lara00/3d-druck-schubladen-kalender/stl/1_Monatskalender/1_Module/modul_10_oktober.stl

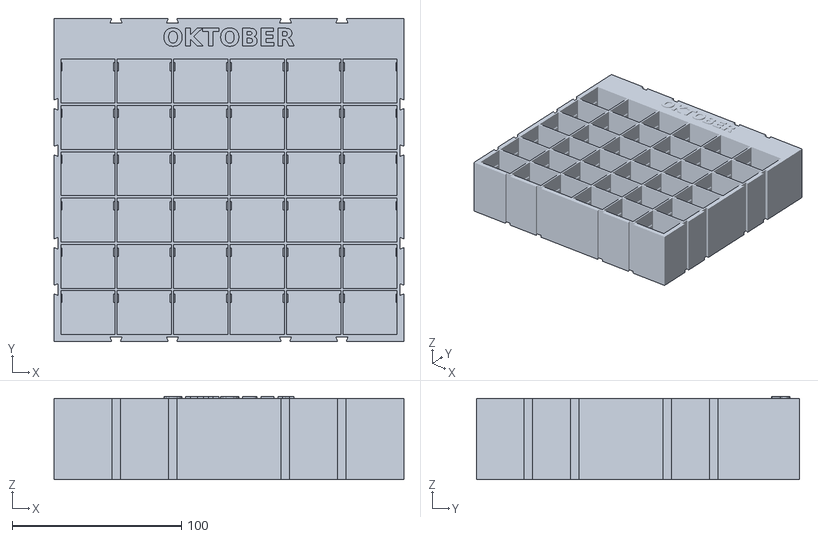
[picture p1: CAD file, 2026-10-16]
stl/1_Monatskalender/1_Module/modul_10_oktober.stl
207.0 x 191.0 x 49.2
