lara00/3d-druck-schubladen-kalender/stl/1_Monatskalender/2_Schubladen/schubladen_tag_01-31_12x_drucken.stl

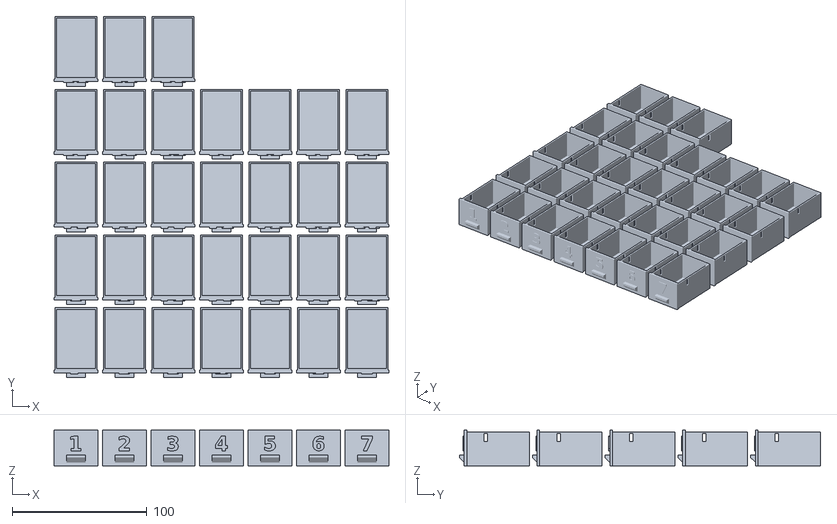
[picture p2: CAD file, 2026-10-16]
stl/1_Monatskalender/2_Schubladen/schubladen_tag_01-31_12x_drucken.stl
248.4 x 267.8 x 26.4
