lara00/3d-druck-schubladen-kalender/stl/1_Monatskalender/3_Verbinder/verbinder_68x.stl

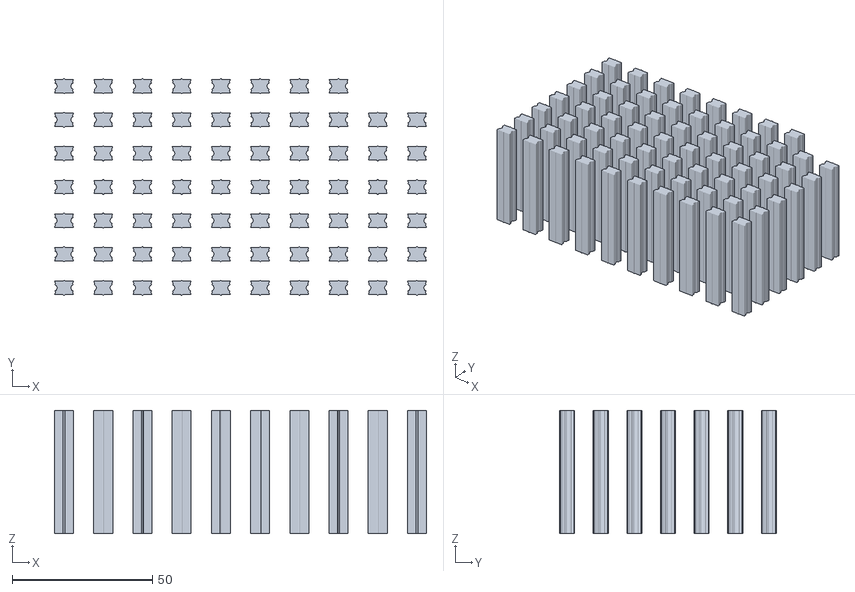
[picture p3: CAD file, 2026-10-16]
stl/1_Monatskalender/3_Verbinder/verbinder_68x.stl
132.8 x 77.4 x 44.0
