lara00/3d-druck-schubladen-kalender/stl/1_Monatskalender/4_Abschlussleisten/leiste_rechts_oben_ecke.stl

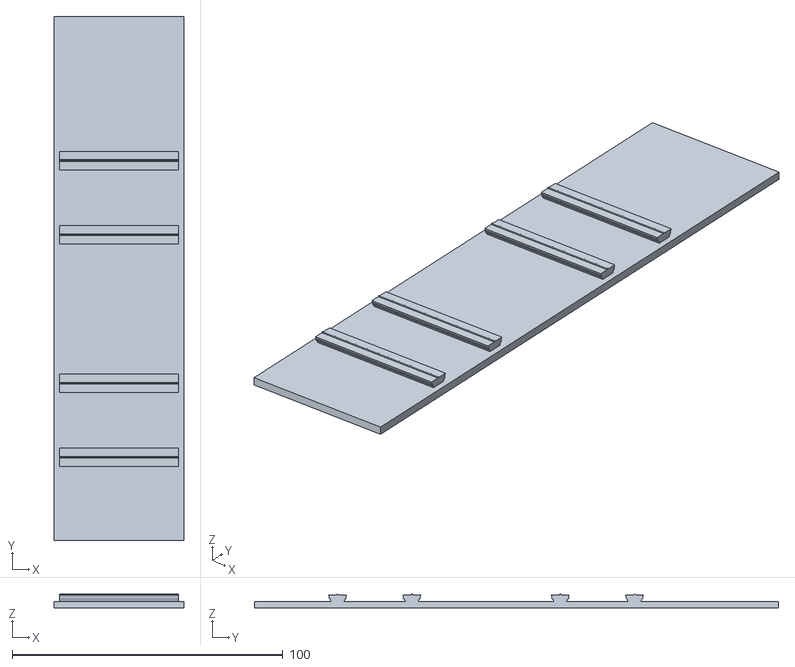
[picture p4: CAD file, 2026-10-16]
stl/1_Monatskalender/4_Abschlussleisten/leiste_rechts_oben_ecke.stl
48.0 x 193.5 x 5.20
