lara00/3d-druck-schubladen-kalender/stl/2_Adventskalender/advent_schubladen_1-24.stl

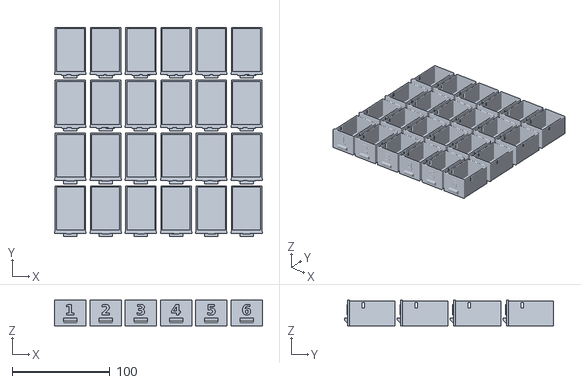
[picture p5: CAD file, 2026-10-16]
stl/2_Adventskalender/advent_schubladen_1-24.stl
212.4 x 213.8 x 26.4
