lara00/3d-druck-schubladen-kalender/stl/3_Testmodul/testmodul_2x2.stl

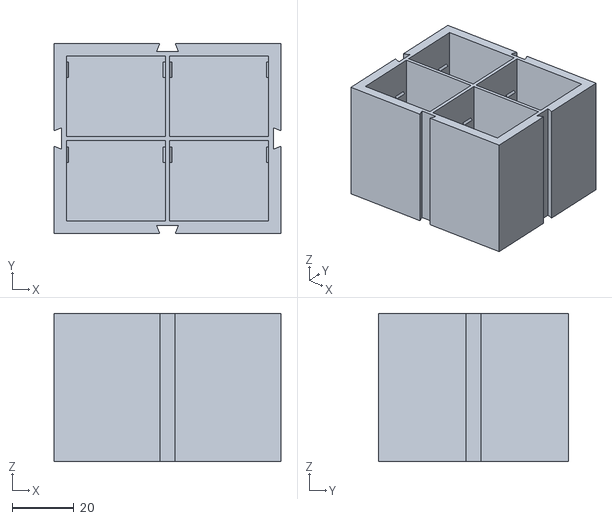
[picture p6: CAD file, 2026-10-16]
stl/3_Testmodul/testmodul_2x2.stl
73.4 x 61.4 x 48.0
