lara00/3d-druck-schubladen-kalender/stl/4_Extra_Schubladen/doppel_schubladen_4_2x.stl

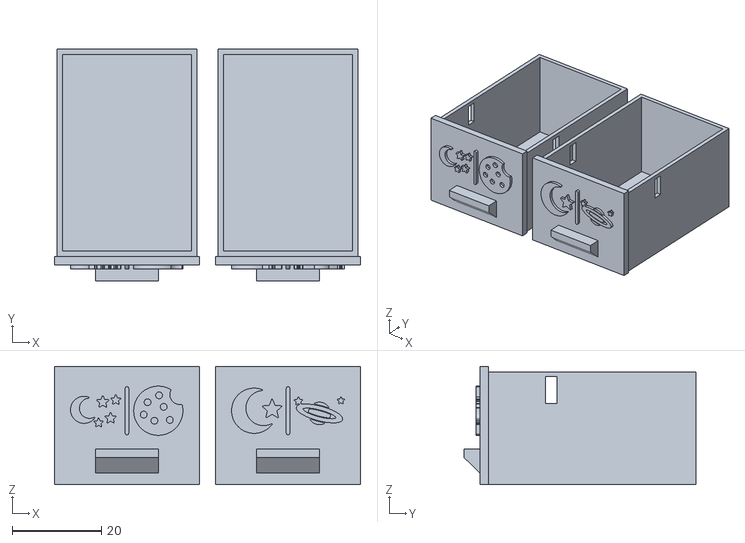
[picture p7: CAD file, 2026-10-16]
stl/4_Extra_Schubladen/doppel_schubladen_4_2x.stl
68.4 x 51.8 x 26.4
