lara00/3d-druck-schubladen-kalender/stl/4_Extra_Schubladen/monat_zahlen/zahlen_okt_01-31.stl

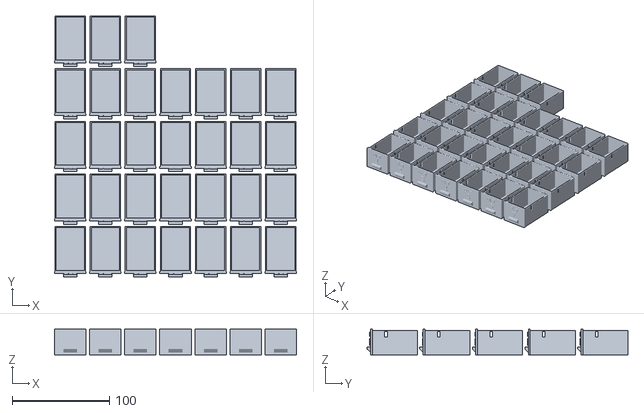
[picture p8: CAD file, 2026-10-16]
stl/4_Extra_Schubladen/monat_zahlen/zahlen_okt_01-31.stl
248.4 x 267.8 x 26.4
