lara00/3d-druck-schubladen-kalender/stl/4_Extra_Schubladen/tage_im_jahr/tage_04_109-144.stl

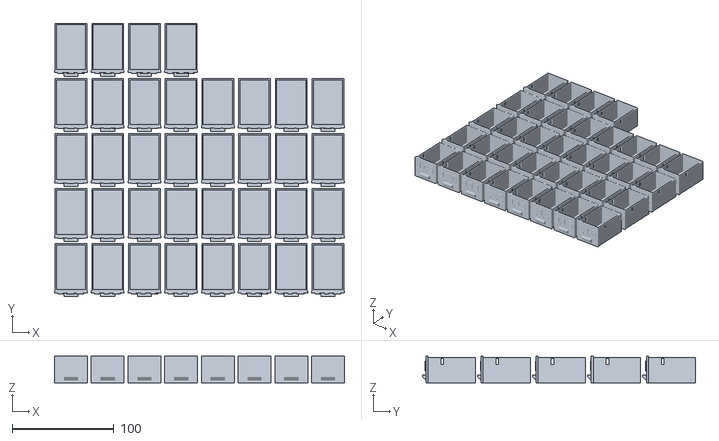
[picture p9: CAD file, 2026-10-16]
stl/4_Extra_Schubladen/tage_im_jahr/tage_04_109-144.stl
284.4 x 267.8 x 26.4
