lara00/3d-druck-schubladen-kalender/stl/4_Extra_Schubladen/weitere_symbole/schubladen_zeichen_10x.stl

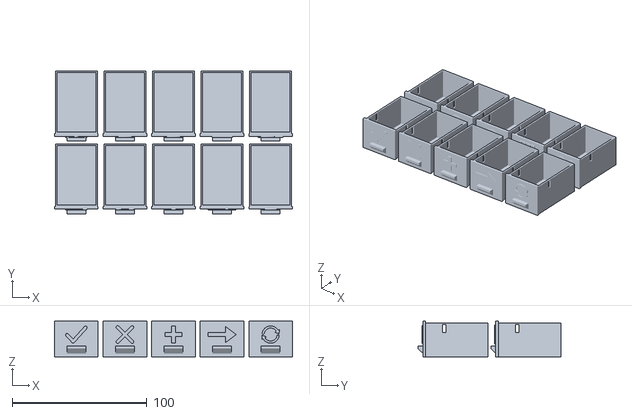
[picture p10: CAD file, 2026-10-16]
stl/4_Extra_Schubladen/weitere_symbole/schubladen_zeichen_10x.stl
176.4 x 105.8 x 26.4
