lara00/3d-druck-schubladen-kalender/stl/4_Extra_Schubladen/welt_feiertage/schubladen_religionen_11x.stl

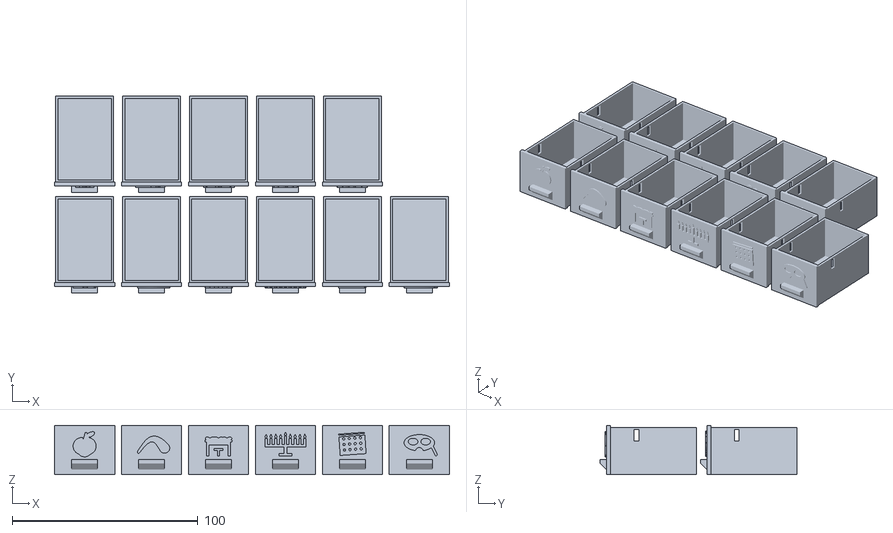
[picture p11: CAD file, 2026-10-16]
stl/4_Extra_Schubladen/welt_feiertage/schubladen_religionen_11x.stl
212.4 x 105.8 x 26.4
