lara00/3d-druck-schubladen-kalender/stl/einzeln/wz_su_03.stl

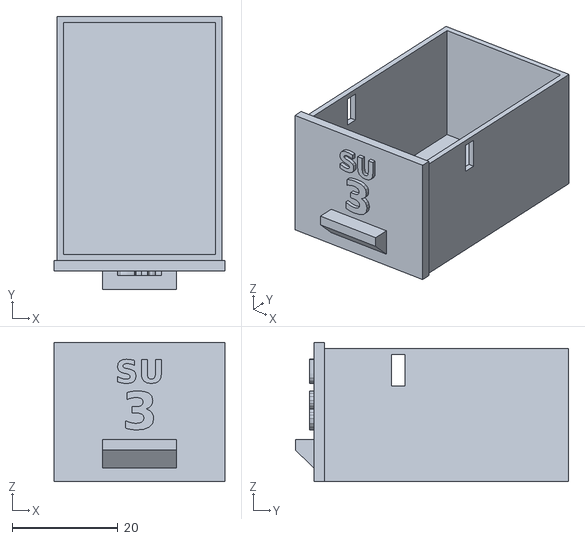
[picture p12: CAD file, 2026-10-16]
stl/einzeln/wz_su_03.stl
32.4 x 51.8 x 26.4
