lara00/3d-druck-schubladen-kalender/stl/1_Monatskalender/4_Abschlussleisten/leiste_oben_unten_8x.stl

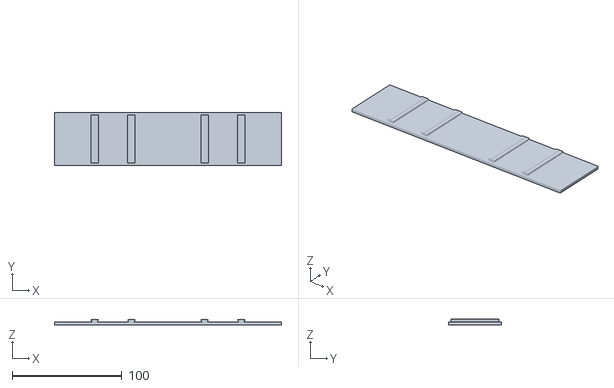
[picture p13: CAD file, 2026-10-16]
stl/1_Monatskalender/4_Abschlussleisten/leiste_oben_unten_8x.stl
207.0 x 48.0 x 5.20
