lara00/3d-druck-schubladen-kalender/stl/2_Adventskalender/advent_regal.stl

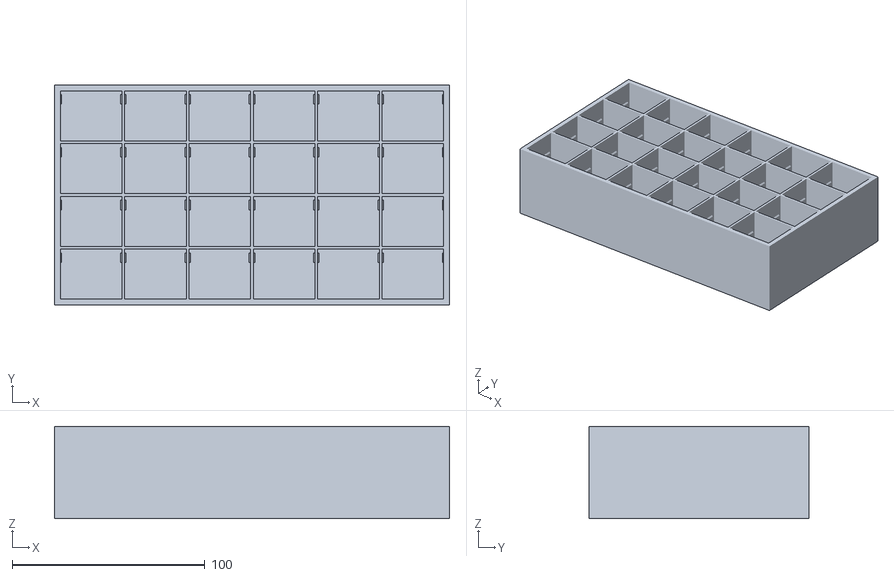
[picture p14: CAD file, 2026-10-16]
stl/2_Adventskalender/advent_regal.stl
205.0 x 114.2 x 48.0
