lara00/3d-druck-schubladen-kalender/stl/3_Testmodul/test_verbinder_passungen_6x.stl

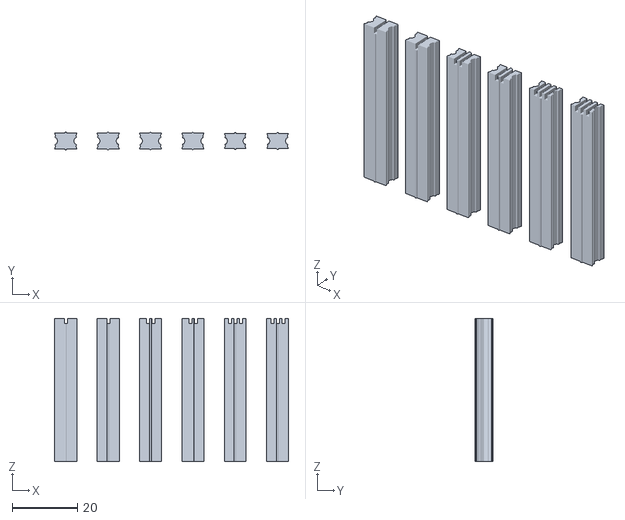
[picture p15: CAD file, 2026-10-16]
stl/3_Testmodul/test_verbinder_passungen_6x.stl
71.8 x 5.50 x 44.0
