lara00/3d-druck-schubladen-kalender/stl/4_Extra_Schubladen/schubladen_jahreszeiten_feste_6x.stl

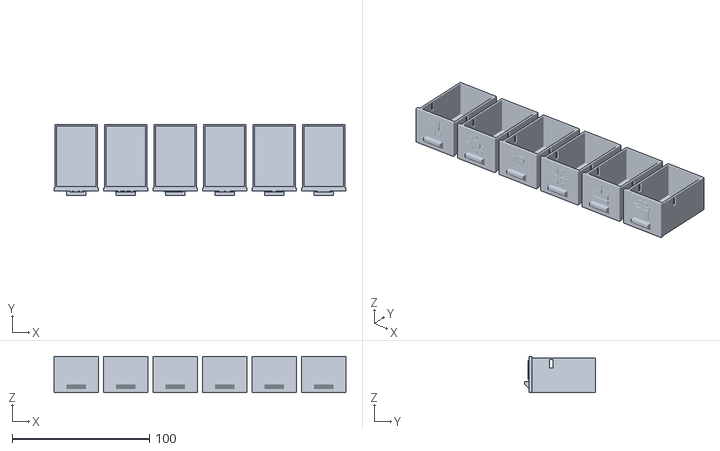
[picture p16: CAD file, 2026-10-16]
stl/4_Extra_Schubladen/schubladen_jahreszeiten_feste_6x.stl
212.4 x 51.8 x 26.4
