lara00/3d-druck-schubladen-kalender/stl/5_Stimmungskalender/mood_calendar_modul.stl

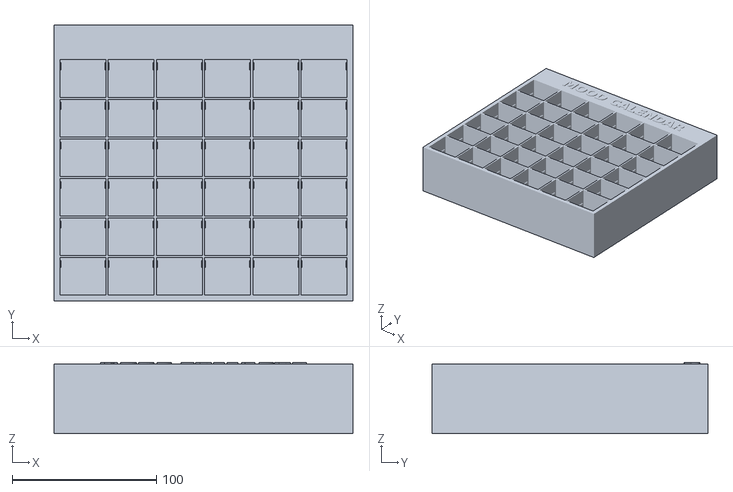
[picture p18: CAD file, 2026-10-16]
stl/5_Stimmungskalender/mood_calendar_modul.stl
207.0 x 191.0 x 49.2
