lara00/3d-druck-schubladen-kalender/stl/4_Extra_Schubladen/schubladen_symbole_7x.stl

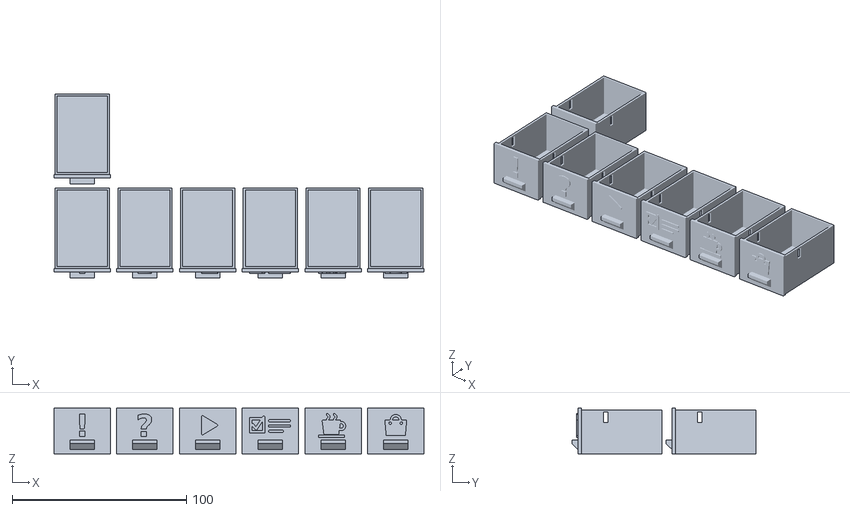
[picture p19: CAD file, 2026-10-16]
stl/4_Extra_Schubladen/schubladen_symbole_7x.stl
212.4 x 105.8 x 26.4
