lara00/3d-druck-schubladen-kalender/stl/4_Extra_Schubladen/welt_feiertage/schubladen_international_13x.stl

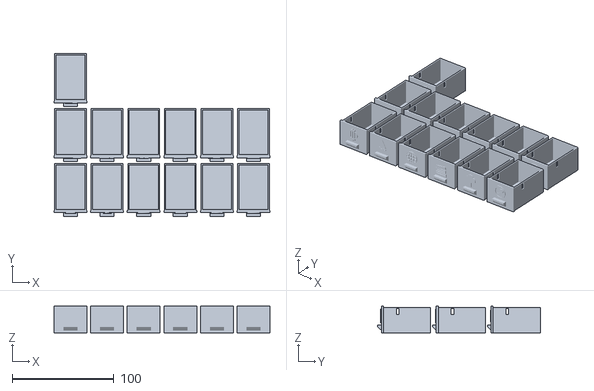
[picture p20: CAD file, 2026-10-16]
stl/4_Extra_Schubladen/welt_feiertage/schubladen_international_13x.stl
212.4 x 159.8 x 26.4
