lara00/3d-druck-schubladen-kalender/stl/3_Testmodul/test_abschlussleisten_4x.stl

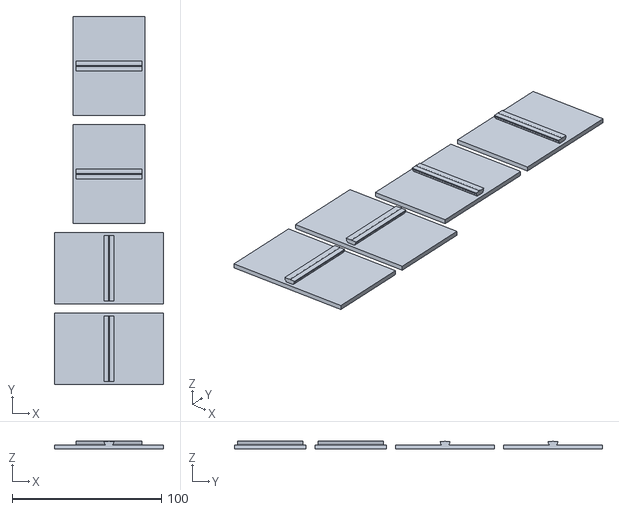
[picture p21: CAD file, 2026-10-16]
stl/3_Testmodul/test_abschlussleisten_4x.stl
73.4 x 246.8 x 5.20
