lara00/3d-druck-schubladen-kalender/stl/6_Lernkalender/schubladen_stunden_15min-7h30_30x.stl

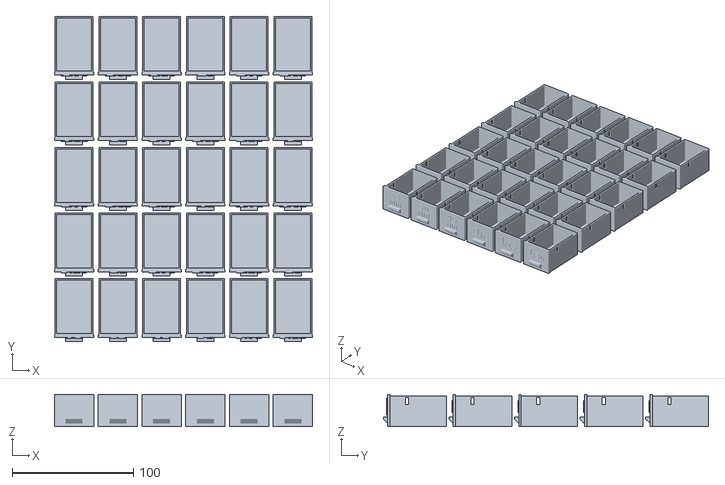
[picture p22: CAD file, 2026-10-16]
stl/6_Lernkalender/schubladen_stunden_15min-7h30_30x.stl
212.4 x 267.8 x 26.4
