lara00/3d-druck-schubladen-kalender/stl/4_Extra_Schubladen/monat_zahlen/zahlen_feb_01-29.stl

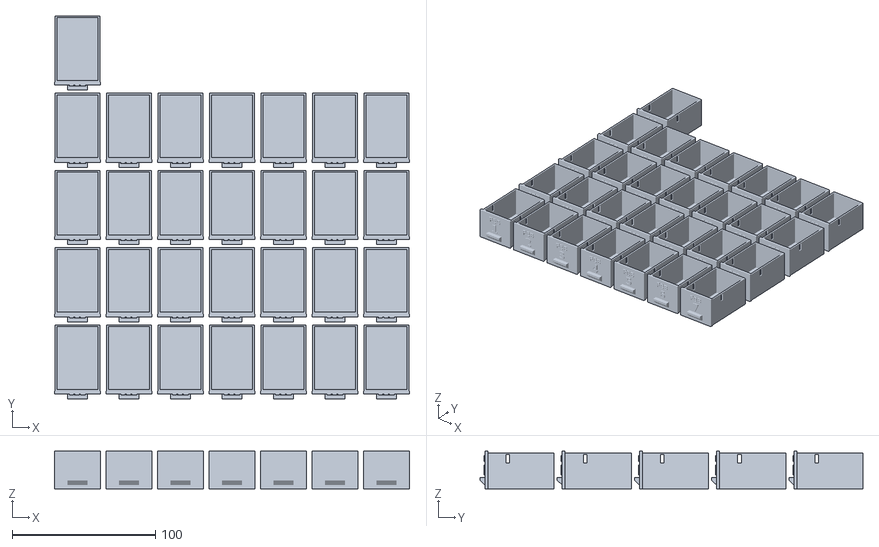
[picture p23: CAD file, 2026-10-16]
stl/4_Extra_Schubladen/monat_zahlen/zahlen_feb_01-29.stl
248.4 x 267.8 x 26.4
