lara00/3d-druck-schubladen-kalender/stl/4_Extra_Schubladen/schubladen_feiertage_20x.stl

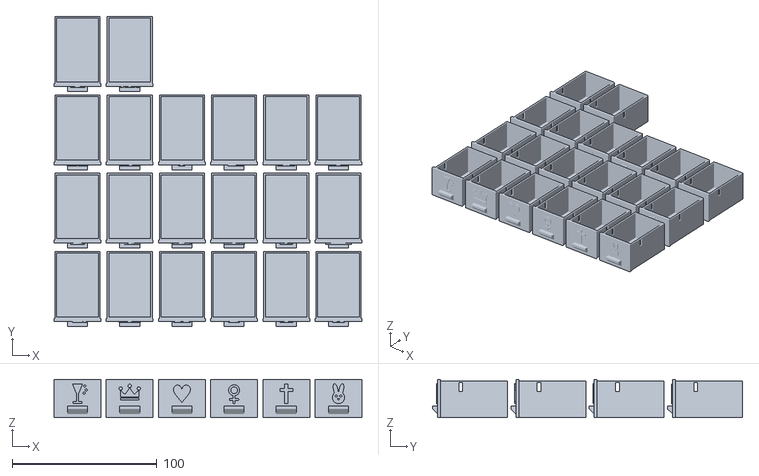
[picture p24: CAD file, 2026-10-16]
stl/4_Extra_Schubladen/schubladen_feiertage_20x.stl
212.4 x 213.8 x 26.4
