lara00/3d-druck-schubladen-kalender/stl/4_Extra_Schubladen/monat_zahlen/zahlen_nov_01-30.stl

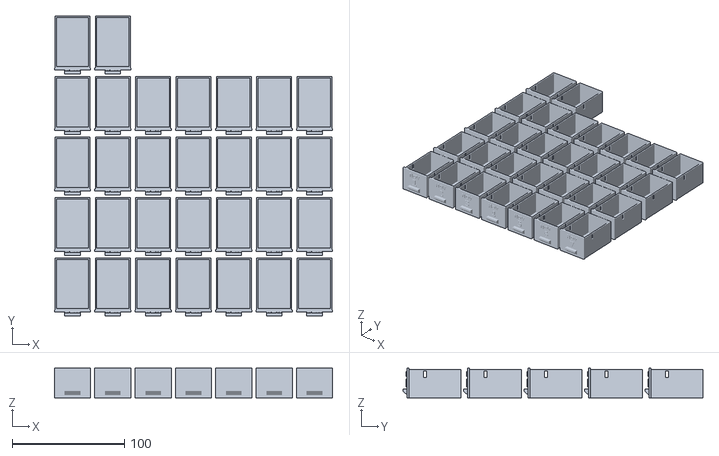
[picture p26: CAD file, 2026-10-16]
stl/4_Extra_Schubladen/monat_zahlen/zahlen_nov_01-30.stl
248.4 x 267.8 x 26.4
