lara00/3d-druck-schubladen-kalender/stl/4_Extra_Schubladen/weitere_symbole/schubladen_gesichter2_20x.stl

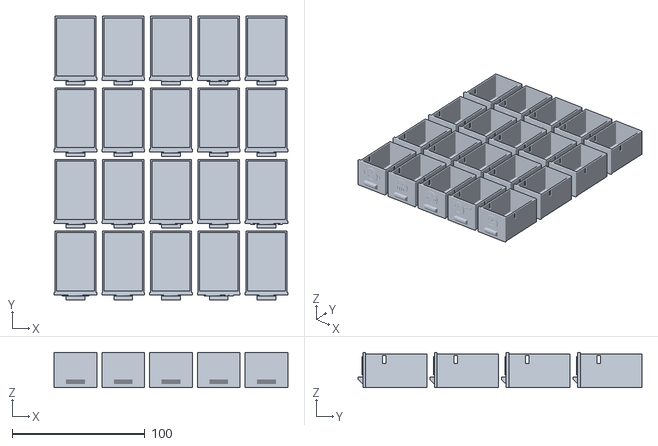
[picture p27: CAD file, 2026-10-16]
stl/4_Extra_Schubladen/weitere_symbole/schubladen_gesichter2_20x.stl
176.4 x 213.8 x 26.4
