lara00/3d-druck-schubladen-kalender/stl/einzeln/zeichen_0050.stl

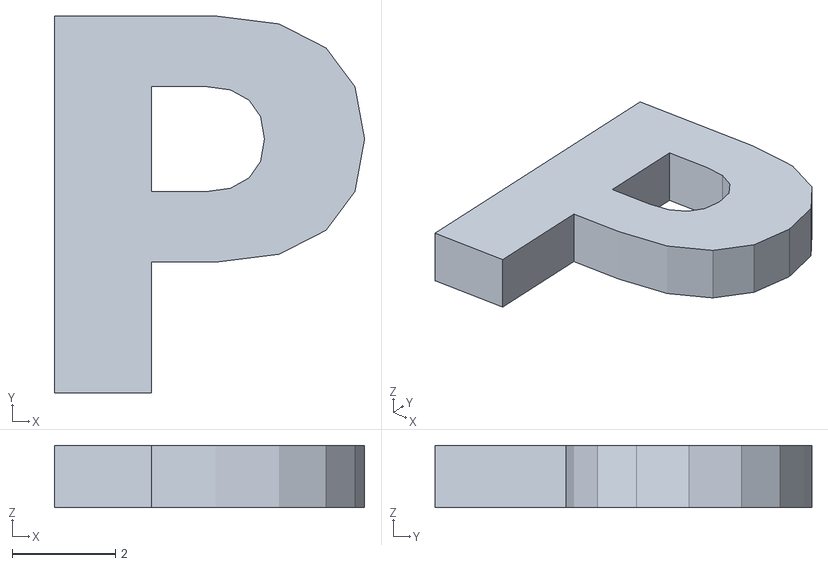
[picture p28: CAD file, 2026-10-16]
stl/einzeln/zeichen_0050.stl
6.00 x 7.29 x 1.20
