lara00/3d-druck-schubladen-kalender/stl/4_Extra_Schubladen/schubladen_laender_feiertage_21x.stl

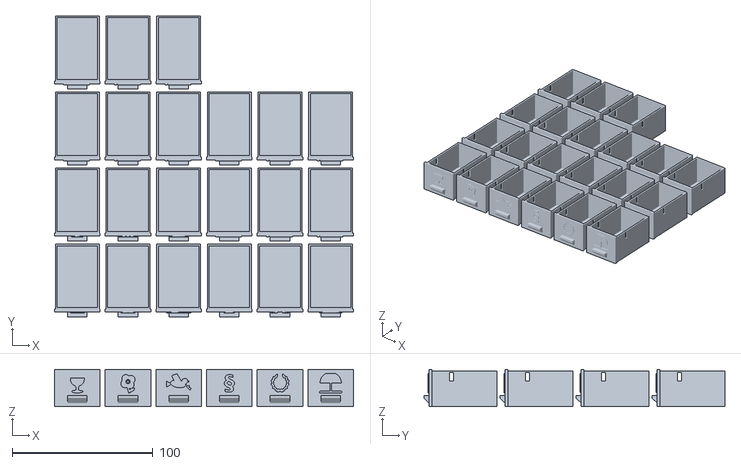
[picture p30: CAD file, 2026-10-16]
stl/4_Extra_Schubladen/schubladen_laender_feiertage_21x.stl
212.4 x 213.8 x 26.4
