lara00/3d-druck-schubladen-kalender/stl/4_Extra_Schubladen/buchstaben_gross_29x.stl

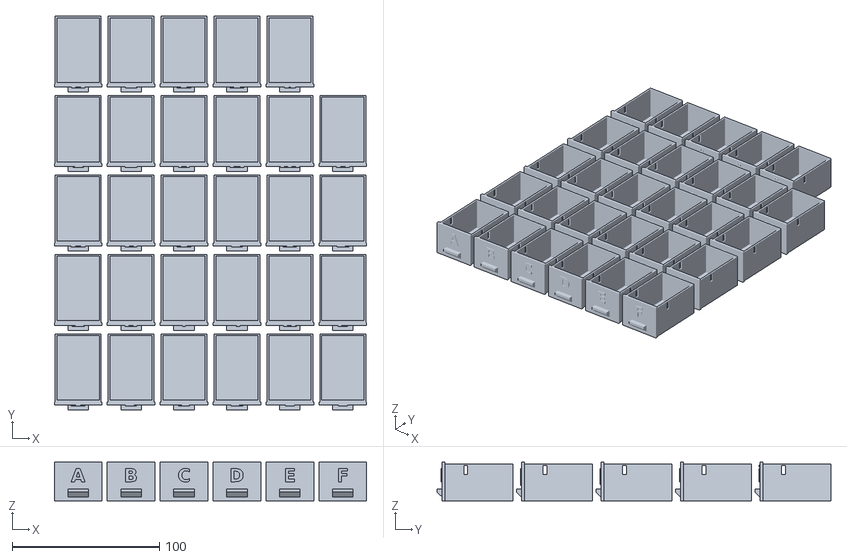
[picture p32: CAD file, 2026-10-16]
stl/4_Extra_Schubladen/buchstaben_gross_29x.stl
212.4 x 267.8 x 26.4
