lara00/3d-druck-schubladen-kalender/(list of files, cad)

Other CAD files:
stl/1_Monatskalender/1_Module_EN/module_07_july.stl
stl/4_Extra_Schubladen/wochentag_zahlen/zahlen_so_01-31.stl
stl/5_Stimmungskalender/mood_calendar_modul_mit_nuten.stl
stl/6_Lernkalender/lernkalender_modul_mit_nuten.stl
stl/1_Monatskalender/1_Module/modul_07_juli.stl
stl/1_Monatskalender/1_Module_EN/module_05_may.stl
stl/4_Extra_Schubladen/monat_zahlen/zahlen_mai_01-31.stl
stl/4_Extra_Schubladen/tage_im_jahr/tage_03_073-108.stl
stl/4_Extra_Schubladen/welt_feiertage/schubladen_laender_12x.stl
stl/4_Extra_Schubladen/wochentag_zahlen/zahlen_th_01-31.stl
stl/einzeln/n_paragraph.stl
stl/1_Monatskalender/1_Module/modul_01_januar.stl
stl/1_Monatskalender/1_Module_EN/module_10_october.stl
stl/1_Monatskalender/4_Abschlussleisten/leiste_rechts_unten_ecke.stl
stl/3_Testmodul/test_schubladen_1-12.stl
stl/4_Extra_Schubladen/monat_zahlen/zahlen_maer_01-31.stl
stl/4_Extra_Schubladen/tage_im_jahr/tage_11_361-366.stl
stl/4_Extra_Schubladen/weitere_symbole/schubladen_essen_10x.stl
stl/4_Extra_Schubladen/wochentag_zahlen/zahlen_do_01-31.stl
stl/5_Stimmungskalender/stimmung_3_okay_10x.stl
stl/6_Lernkalender/study_calendar_modul.stl
stl/einzeln/wz_di_23.stl
stl/1_Monatskalender/1_Module/modul_05_mai.stl
stl/1_Monatskalender/1_Module_EN/module_09_september.stl
stl/1_Monatskalender/4_Abschlussleisten/leiste_links_unten_ecke.stl
stl/4_Extra_Schubladen/monat_zahlen/zahlen_aug_01-31.stl
stl/4_Extra_Schubladen/schubladen_alltag_12x.stl
stl/4_Extra_Schubladen/tage_im_jahr/tage_09_289-324.stl
stl/4_Extra_Schubladen/weitere_symbole/schubladen_natur_10x.stl
stl/4_Extra_Schubladen/welt_feiertage/schubladen_aktionstage_12x.stl
stl/4_Extra_Schubladen/wochentag_zahlen/zahlen_mi_01-31.stl
stl/einzeln/wz_th_19.stl
stl/1_Monatskalender/1_Module/modul_03_maerz.stl
stl/1_Monatskalender/1_Module_EN/module_11_november.stl
stl/1_Monatskalender/4_Abschlussleisten/leiste_links_oben_ecke.stl
stl/4_Extra_Schubladen/tage_im_jahr/tage_02_037-072.stl
stl/4_Extra_Schubladen/weitere_symbole/schubladen_feiern_10x.stl
stl/4_Extra_Schubladen/wochentag_zahlen/zahlen_we_01-31.stl
stl/5_Stimmungskalender/stimmungskalender_modul.stl
stl/6_Lernkalender/lernkalender_modul.stl
stl/einzeln/tag_074.stl
stl/1_Monatskalender/1_Module/modul_04_april.stl
stl/1_Monatskalender/1_Module_EN/module_03_march.stl
stl/1_Monatskalender/4_Abschlussleisten/leiste_rechts_mitte.stl
stl/4_Extra_Schubladen/monat_zahlen/zahlen_dec_01-31.stl
stl/4_Extra_Schubladen/tage_im_jahr/tage_10_325-360.stl
stl/4_Extra_Schubladen/weitere_symbole/schubladen_tiere_10x.stl
stl/4_Extra_Schubladen/wochentag_zahlen/zahlen_su_01-31.stl
stl/5_Stimmungskalender/stimmungskalender_modul_mit_nuten.stl
stl/6_Lernkalender/study_calendar_modul_mit_nuten.stl
stl/einzeln/tag_221.stl
stl/1_Monatskalender/1_Module/modul_12_dezember.stl
stl/1_Monatskalender/1_Module_EN/module_06_june.stl
stl/1_Monatskalender/4_Abschlussleisten/leiste_links_mitte.stl
stl/4_Extra_Schubladen/monat_zahlen/zahlen_dez_01-31.stl
stl/4_Extra_Schubladen/schubladen_termine_12x.stl
stl/4_Extra_Schubladen/tage_im_jahr/tage_08_253-288.stl
stl/4_Extra_Schubladen/weitere_symbole/schubladen_buero_10x.stl
stl/4_Extra_Schubladen/wochentag_zahlen/zahlen_tu_01-31.stl
stl/5_Stimmungskalender/stimmung_4_gut_10x.stl
stl/6_Lernkalender/schubladen_stunden_7h45-15h_30x.stl
stl/einzeln/n_europa.stl
stl/1_Monatskalender/1_Module/modul_02_februar.stl
stl/1_Monatskalender/1_Module_EN/module_04_april.stl
stl/4_Extra_Schubladen/monat_zahlen/zahlen_may_01-31.stl
stl/4_Extra_Schubladen/schubladen_islamische_tage_11x.stl
stl/4_Extra_Schubladen/tage_im_jahr/tage_07_217-252.stl
stl/4_Extra_Schubladen/weitere_symbole/schubladen_pflege_10x.stl
stl/4_Extra_Schubladen/wochentag_zahlen/zahlen_di_01-31.stl
stl/5_Stimmungskalender/stimmung_5_super_10x.stl
stl/6_Lernkalender/schubladen_stunden_15h15-20h_20x.stl
stl/einzeln/w_laender_mariae_empfaengnis.stl
stl/1_Monatskalender/1_Module/modul_09_september.stl
stl/1_Monatskalender/1_Module_EN/module_08_august.stl
stl/4_Extra_Schubladen/schubladen_sport_12x.stl
stl/4_Extra_Schubladen/tage_im_jahr/tage_06_181-216.stl
stl/4_Extra_Schubladen/weitere_symbole/schubladen_gesichter_10x.stl
stl/4_Extra_Schubladen/wochentag_zahlen/zahlen_mo_01-31.stl
stl/5_Stimmungskalender/stimmung_2_schlecht_10x.stl
stl/einzeln/mz_aug_20.stl
stl/1_Monatskalender/1_Module/modul_06_juni.stl
stl/1_Monatskalender/1_Module_EN/module_12_december.stl
stl/4_Extra_Schubladen/buchstaben_klein_30x.stl
stl/4_Extra_Schubladen/monat_zahlen/zahlen_jan_01-31.stl
stl/4_Extra_Schubladen/tage_im_jahr/tage_05_145-180.stl
stl/4_Extra_Schubladen/weitere_symbole/schubladen_unterwegs_10x.stl
stl/4_Extra_Schubladen/wochentag_zahlen/zahlen_sa_01-31.stl
stl/5_Stimmungskalender/stimmung_1_mies_10x.stl
stl/einzeln/z_studium_klausur.stl
stl/1_Monatskalender/1_Module/modul_08_august.stl
stl/1_Monatskalender/1_Module_EN/module_02_february.stl
stl/4_Extra_Schubladen/monat_zahlen/zahlen_jul_01-31.stl
stl/4_Extra_Schubladen/schubladen_leer_12x.stl
stl/4_Extra_Schubladen/tage_im_jahr/tage_01_001-036.stl
stl/4_Extra_Schubladen/wochentag_zahlen/zahlen_fr_01-31.stl
stl/einzeln/mz_feb_19.stl
stl/1_Monatskalender/1_Module/modul_11_november.stl
stl/1_Monatskalender/1_Module_EN/module_01_january.stl
stl/4_Extra_Schubladen/monat_zahlen/zahlen_mar_01-31.stl
stl/4_Extra_Schubladen/schubladen_muster_12x.stl
stl/4_Extra_Schubladen/weitere_symbole/schubladen_zuhause_10x.stl
stl/einzeln/wz_di_26.stl
stl/4_Extra_Schubladen/monat_zahlen/zahlen_oct_01-31.stl
stl/4_Extra_Schubladen/schubladen_hobby_12x.stl
stl/4_Extra_Schubladen/monat_zahlen/zahlen_sep_01-30.stl
stl/einzeln/k_i_mawlid__w_aktionstage_pommes.stl
stl/4_Extra_Schubladen/monat_zahlen/zahlen_apr_01-30.stl
stl/einzeln/w_mi.stl
stl/4_Extra_Schubladen/doppel_schubladen_3_11x.stl
stl/4_Extra_Schubladen/monat_zahlen/zahlen_jun_01-30.stl
stl/einzeln/z_essen_brot.stl
stl/einzeln/mz_apr_07.stl
stl/4_Extra_Schubladen/schubladen_bildsymbole_12x.stl
stl/einzeln/wz_so_02.stl
stl/4_Extra_Schubladen/schubladen_wochentage_7x.stl
stl/einzeln/tag_297.stl
stl/4_Extra_Schubladen/dreifach_schubladen_2x.stl
stl/4_Extra_Schubladen/schubladen_flaggen_9x.stl
stl/einzeln/bg_0.stl
stl/einzeln/bg_1.stl
stl/einzeln/bg_10.stl
stl/einzeln/bg_11.stl
stl/einzeln/bg_12.stl
stl/einzeln/bg_13.stl
stl/einzeln/bg_14.stl
stl/einzeln/bg_15.stl
stl/einzeln/bg_16.stl
stl/einzeln/bg_17.stl
stl/einzeln/bg_18.stl
stl/einzeln/bg_19.stl
stl/einzeln/bg_2.stl
stl/einzeln/bg_20.stl
stl/einzeln/bg_21.stl
stl/einzeln/bg_22.stl
stl/einzeln/bg_23.stl
stl/einzeln/bg_24.stl
stl/einzeln/bg_25.stl
stl/einzeln/bg_26.stl
stl/einzeln/bg_27.stl
stl/einzeln/bg_28.stl
stl/einzeln/bg_3.stl
stl/einzeln/bg_4.stl
stl/einzeln/bg_5.stl
stl/einzeln/bg_6.stl
stl/einzeln/bg_7.stl
stl/einzeln/bg_8.stl
stl/einzeln/bg_9.stl
stl/einzeln/bk_0.stl
stl/einzeln/bk_1.stl
stl/einzeln/bk_10.stl
stl/einzeln/bk_11.stl
stl/einzeln/bk_12.stl
stl/einzeln/bk_13.stl
stl/einzeln/bk_14.stl
stl/einzeln/bk_15.stl
stl/einzeln/bk_16.stl
stl/einzeln/bk_17.stl
stl/einzeln/bk_18.stl
stl/einzeln/bk_19.stl
stl/einzeln/bk_2.stl
stl/einzeln/bk_20.stl
stl/einzeln/bk_21.stl
stl/einzeln/bk_22.stl
stl/einzeln/bk_23.stl
stl/einzeln/bk_24.stl
stl/einzeln/bk_25.stl
stl/einzeln/bk_26.stl
stl/einzeln/bk_27.stl
stl/einzeln/bk_28.stl
stl/einzeln/bk_29.stl
stl/einzeln/bk_3.stl
stl/einzeln/bk_4.stl
stl/einzeln/bk_5.stl
stl/einzeln/bk_6.stl
stl/einzeln/bk_7.stl
stl/einzeln/bk_8.stl
stl/einzeln/bk_9.stl
stl/einzeln/f_allerheiligen.stl
stl/einzeln/f_drei_koenige.stl
stl/einzeln/f_einheit.stl
stl/einzeln/f_frauentag.stl
stl/einzeln/f_halloween.stl
stl/einzeln/f_heiligabend.stl
stl/einzeln/f_himmelfahrt.stl
stl/einzeln/f_karfreitag.stl
stl/einzeln/f_muttertag.stl
stl/einzeln/f_neujahr.stl
stl/einzeln/f_nikolaus.stl
stl/einzeln/f_ostermontag.stl
stl/einzeln/f_ostersonntag.stl
stl/einzeln/f_pfingstmontag.stl
stl/einzeln/f_reformationstag.stl
stl/einzeln/f_silvester.stl
stl/einzeln/f_tag_der_arbeit.stl
stl/einzeln/f_valentinstag.stl
stl/einzeln/f_weihnachten_1.stl
stl/einzeln/f_weihnachten_2.stl
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
